kopp/DigitalerTeePi/(commit log)

2020-06-09 notes on power supply
2020-06-11 add non-dipping mode (timer only)
